qppd/automated-biosorption-filtration-device/model/Biosorption_Hose_Flow_Sensor_Fittings_1.png

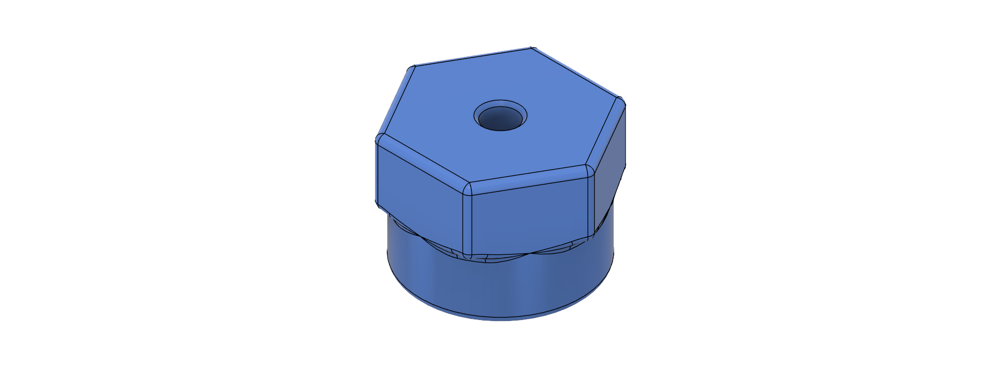
model/Biosorption_Hose_Flow_Sensor_Fittings_1.png
