qppd/automated-biosorption-filtration-device/model/Biosorption_Mixing_Container_Holder.png

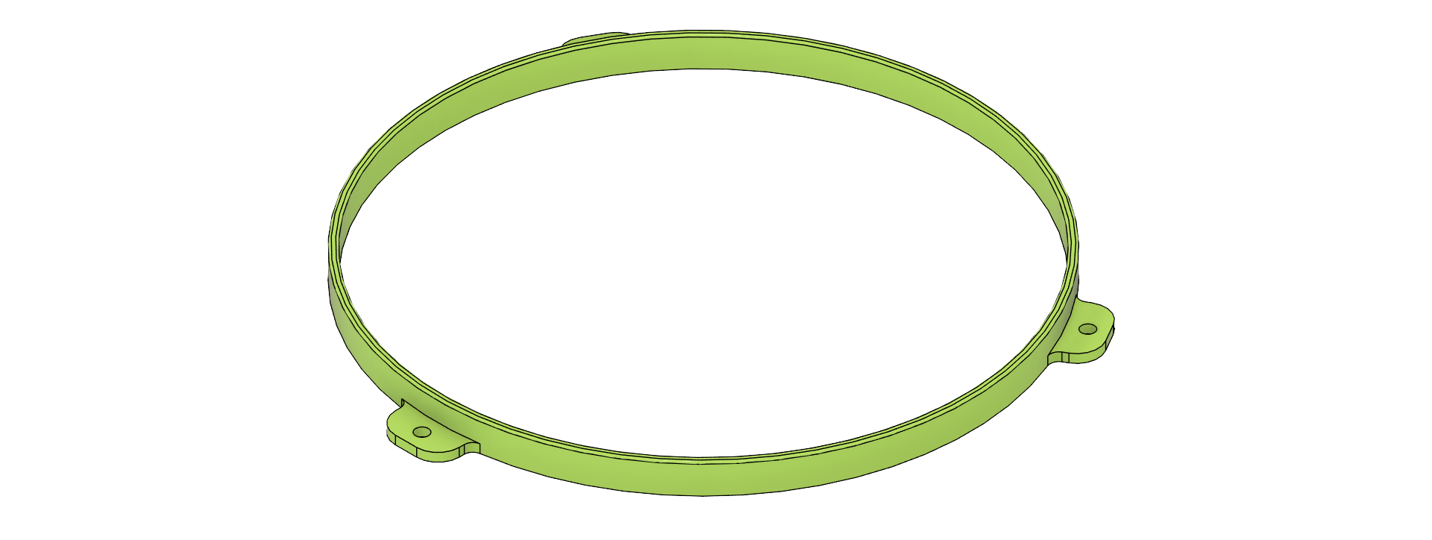
model/Biosorption_Mixing_Container_Holder.png
