qppd/automated-biosorption-filtration-device/(commit log)

2026-10-28 Rework cycle control for two-button, fully automatic operation
    Operator interface:
    - Replace the four navigation buttons with START (GPIO 25) and FORCE STOP
    (GPIO 32). GPIO 5 and 33 are now free.
    - FORCE STOP is handled before the state machines, so it aborts filling or
    stirring in the same loop pass and clears any fault.
    Cycle:
    - Rename FILTERING to DISPENSING. The outlet path has no flow sensor, so the
    LCD prompts Press STOP and the operator ends dispensing by hand.
    - Add FILL_TIMEOUT_MS: a line that never reaches its target volume enters
    FAULT with its relays off instead of pumping indefinitely.
    - Accept START again once both lines are COMPLETE, so batches repeat without
    a powe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
    [BIOSORPTION_STATE_MACHINE.cpp, BIOSORPTION_STATE_MACHINE.h, BUTTON_MODULE.cpp, BUTTON_MODULE.h, BiosorptionFiltration.ino, CONFIG.h, FLOW_SENSOR_MODULE.cpp, LCD_MODULE.cpp]
2026-10-28 Ignore 3D print models and slicer output
    The model/ folder holds STL and gcode files for the printed parts; keep them out of the firmware repository.
2026-11-05 Add model image: Biosorption Hose Flow Sensor Fittings 1
2026-11-05 Add model image: Biosorption Hose Flow Sensor Fittings 2
